Galacs/carte-meteo-lora-2/README.md

# Carte meteo lora 2

## Pin definitions

```c
#define LORA_RST_PIN 24
#define LORA_DIO1_PIN 25
#define LORA_BUSY_PIN 27
#define LORA_DIO3_PIN 26
#define LORA_CS_PIN 3
#define LORA_SCK_PIN 2
#define LORA_MISO_PIN 4
#define LORA_MOSI 5

#define SCL_PIN 6
#define SDA_PIN 7

#define RGB_PIN 23
```
