Galacs/carte-meteo-lora-2/carte-meteo-lora-2.kicad_pcb

## KiCad design carte-meteo-lora-2.kicad_pcb (2026-05-30)

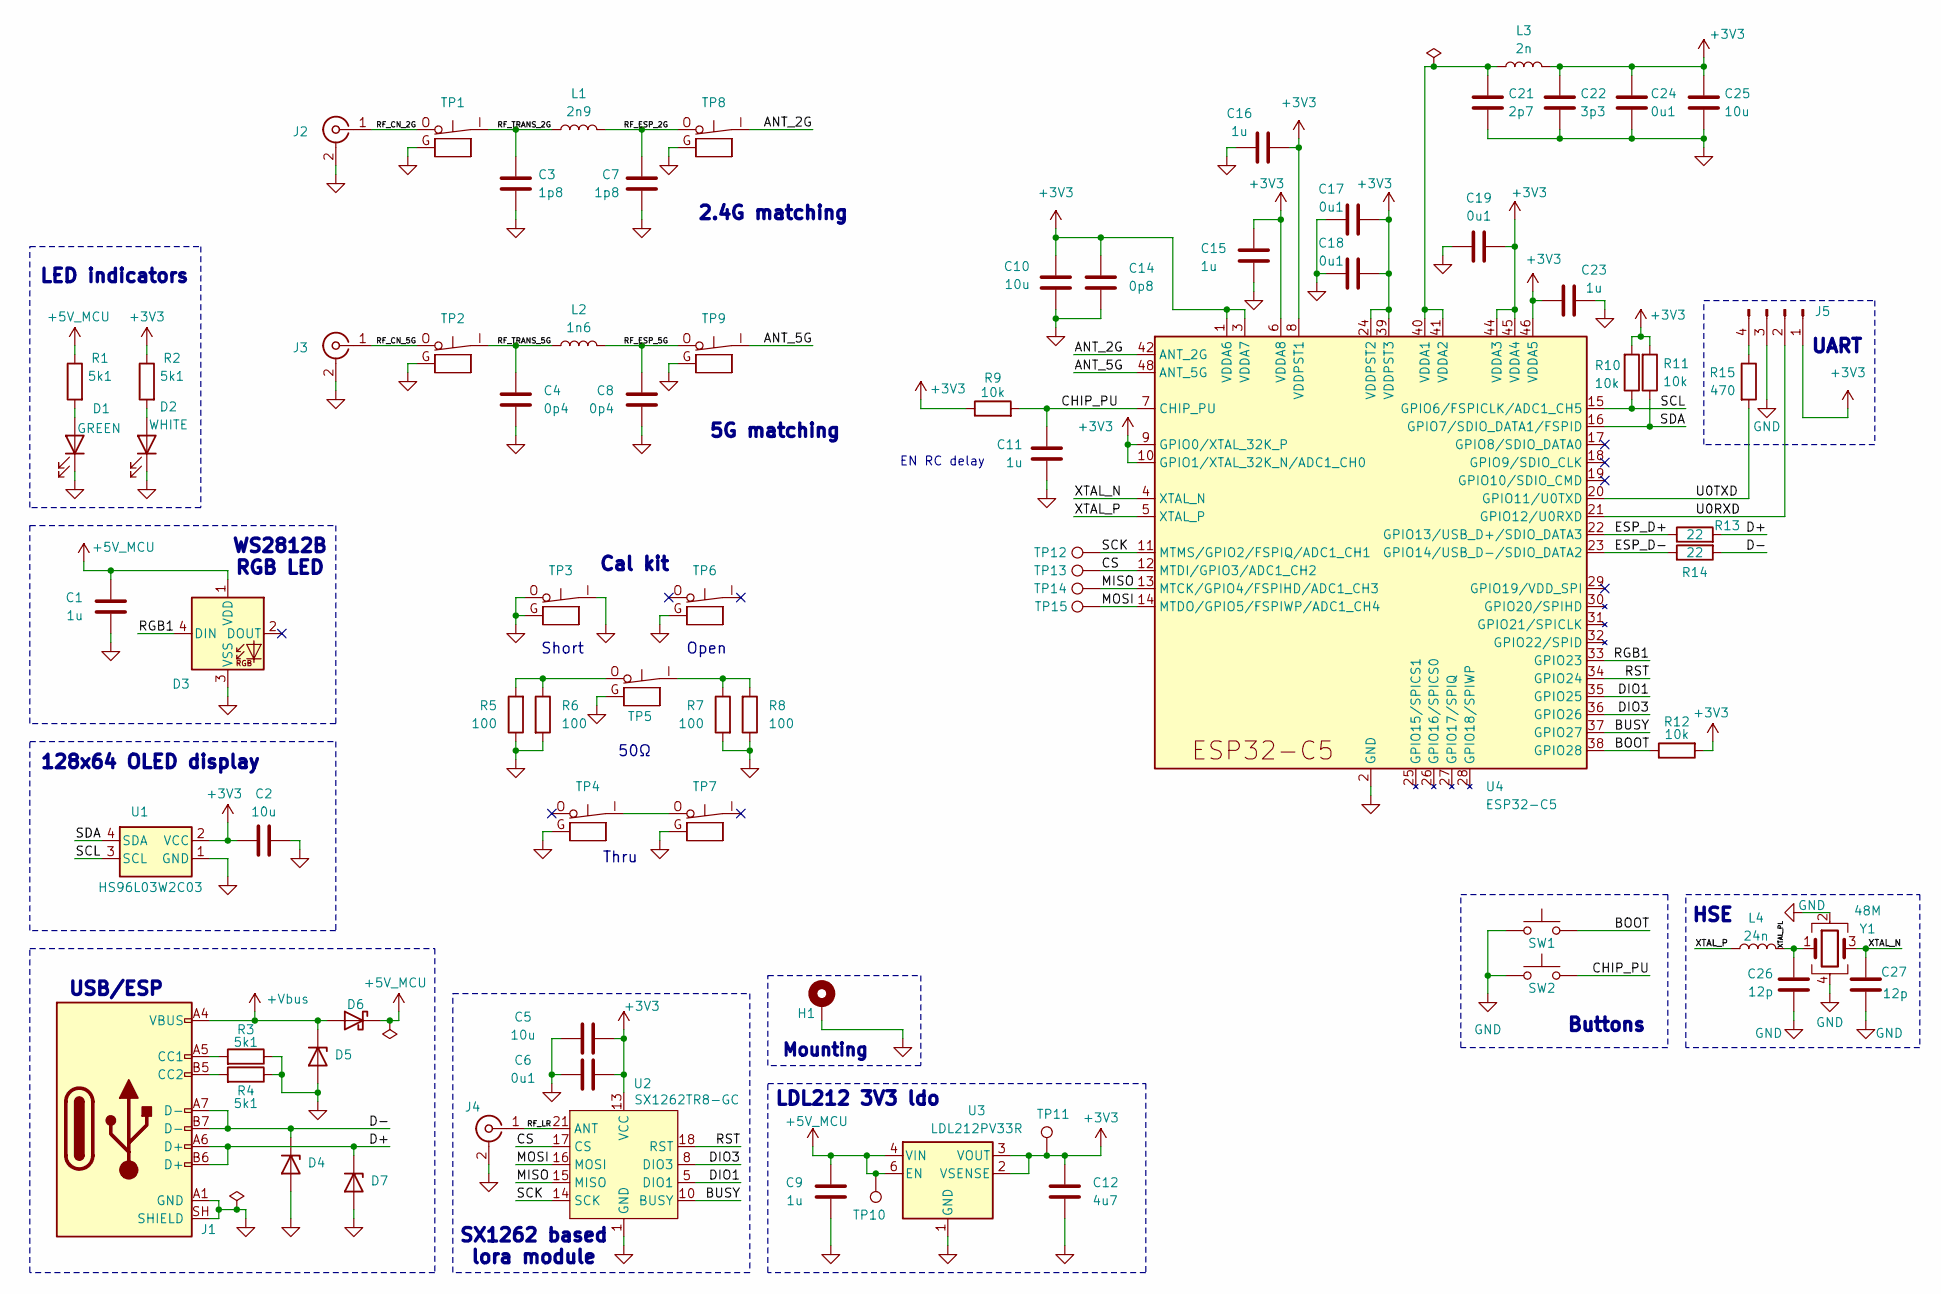
[picture p1: schematic carte-meteo-lora-2.kicad_sch, Carte Meteo Lora 2]

Parts:
C1, C9, C11, C15, C16, C23: 1u; C_0402_1005Metric; Manufacturer Part Number CL05A105KA5NQNC; JLCPCB Part # C52923
C2, C5, C10, C25: 10u; C_0402_1005Metric; Manufacturer Part Number CL05A106MQ5NUNC; JLCPCB Part # C15525
C3, C7: 1p8; C_0402_1005Metric; Manufacturer Part Number GJM1555C1H1R8WB01D; JLCPCB Part # C76903
C4, C8: 0p4; C_0402_1005Metric; Manufacturer Part Number GJM1555C1HR40BB01D; JLCPCB Part # C76910
C6, C17, C18, C19, C24: 0u1; C_0402_1005Metric; Manufacturer Part Number CL05B104KB54PNC; JLCPCB Part # C307331
C12: 4u7; C_0402_1005Metric; Manufacturer Part Number CL05A475MP5NRNC; JLCPCB Part # C23733
C14: 0p8; C_0402_1005Metric; Manufacturer Part Number CC0402BRNPO9BNR80; JLCPCB Part # C327032
C21: 2p7; C_0402_1005Metric; Manufacturer Part Number 0402CG2R7C500NT; JLCPCB Part # C1561
C22: 3p3; C_0402_1005Metric; Manufacturer Part Number 0402CG3R3C500NT; JLCPCB Part # C1565
C26, C27: 12p; C_0402_1005Metric; Manufacturer Part Number 0402CG120J500NT; JLCPCB Part # C1547
D1: GREEN; LED_0805_2012Metric; Manufacturer Part Number KT-0805G; JLCPCB Part # C2297
D2: WHITE; LED_0603_1608Metric; Manufacturer Part Number KT-0603W; JLCPCB Part # C2290
D3: WS2812B; LED_WS2812B_PLCC4_5.0x5.0mm_P3.2mm; Manufacturer Part Number WS2812B-V5/W; JLCPCB Part # C2874885
D4, D5, D7: H5VU10U; Diode_DFN1006; Manufacturer Part Number H5VU10U; JLCPCB Part # C22395519
D6: D_Schottky; D_SMA; Manufacturer Part Number SS54; JLCPCB Part # C22452
H1: MountingHole_Pad; MountingHole_2.2mm_M2_Pad_Via
J1: USB_C_Receptacle_USB2.0_14P; USB_C_Receptacle_HRO_TYPE-C-31-M-12; Manufacturer Part Number TYPE-C16PIN; JLCPCB Part # C393939
J2, J3, J4: Conn_Coaxial; SMA_BAT_Wireless_BWSMA-KWE-Z001; Manufacturer Part Number BWSMA-KWE-Z001; JLCPCB Part # C496551
J5: Conn_01x04_Pin; PinHeader_1x04_P2.54mm_Vertical
L1: 2n9; L_0402_1005Metric; Manufacturer Part Number MWI0402UC2N9JST-HF; JLCPCB Part # C48946217
L2: 1n6; L_0402_1005Metric; Manufacturer Part Number LQG15HS1N6S02D; JLCPCB Part # C162539
L3: 2n; L_0402_1005Metric; Manufacturer Part Number LQG15HS2N0S02D; JLCPCB Part # C18216
L4: 24n; L_0402_1005Metric; Manufacturer Part Number LQW15AN24NG00D; JLCPCB Part # C167472
R1, R2, R3, R4: 5k1; R_0402_1005Metric; Manufacturer Part Number 0402WGF5101TCE; JLCPCB Part # C25905
R5, R6, R7, R8: 100; R_0402_1005Metric; Manufacturer Part Number 0402WGF1000TCE; JLCPCB Part # C25076
R9, R10, R11, R12: 10k; R_0402_1005Metric; Manufacturer Part Number 0402WGF1002TCE; JLCPCB Part # C25744
R13, R14: 22; R_0402_1005Metric; Manufacturer Part Number 0402WGF220JTCE; JLCPCB Part # C25092
R15: 470; R_0402_1005Metric; Manufacturer Part Number 0402WGF4700TCE; JLCPCB Part # C25117
SW1, SW2: SW_Push; SW_SPST_TS-1088-xR020; Manufacturer Part Number TS-1088-AR02016; JLCPCB Part # C720477
TP1, TP2, TP3, TP4, TP5, TP6, TP7, TP8, TP9: RF_switch_connector; Murata_MM8930-2620; Manufacturer Part Number MM8930-2620RJ4; JLCPCB Part # C6227587
TP10, TP11: TestPoint; TestPoint_Pad_D2.0mm
TP12, TP13, TP14, TP15: TestPoint; TestPoint_Pad_D1.0mm
U1: HS96L03W2C03; Manufacturer Part Number HS96L03W2C03; JLCPCB Part # C5248080
U2: SX1262TR8-GC; Silicontra_SX1262ZTR8; Manufacturer Part Number SX1262TR8-GC; JLCPCB Part # C42381682
U3: LDL212PV33R; DFN-6-1EP_2x2mm_P0.5mm_ST; Manufacturer Part Number LDL212PV33R; JLCPCB Part # C2969892
U4: ESP32-C5; QFN-48-1EP_6x6mm_P0.4mm_EP4.6x4.6mm; Manufacturer Part Number ESP32-C5HF4
Y1: 48M; Crystal_SMD_2016-4Pin_2.0x1.6mm; Manufacturer Part Number R940000096; JLCPCB Part # C7206306

Connections:
+3V3: C2.2, C5.1, C6.2, C10.1, C12.1, C14.1, C15.2, C16.2, C17.2, C18.2, C19.1, C22.1, C23.1, C24.1, C25.1, J5.1, L3.2, R2.1, R9.1, R10.2, R11.2, R12.2, TP11.1 (1_1), U1.2 (VCC), U2.13 (VCC), U3.2 (VSENSE), U3.3 (VOUT), U4.1 (VDDA6), U4.3 (VDDA7), U4.6 (VDDA8), U4.8 (VDDPST1), U4.9 (GPIO0/XTAL_32K_P), U4.10 (GPIO1/XTAL_32K_N/ADC1_CH0), U4.24 (VDDPST2), U4.39 (VDDPST3), U4.44 (VDDA3), U4.45 (VDDA4), U4.46 (VDDA5)
+5V_MCU: C1.1, C9.1, D3.1 (VDD), D6.1 (K), R1.1, TP10.1 (1_1), U3.4 (VIN), U3.6 (EN)
+Vbus: D5.1 (K), D6.2 (A), J1.A4 (VBUS), J1.A9 (VBUS), J1.B4 (VBUS), J1.B9 (VBUS)
/ANT_2G: TP8.I, U4.42 (ANT_2G)
/ANT_5G: TP9.I, U4.48 (ANT_5G)
/BOOT: R12.1, SW1.2, U4.38 (GPIO28)
/BUSY: U2.10 (BUSY), U4.37 (GPIO27)
/CHIP_PU: C11.1, R9.2, SW2.2, U4.7 (CHIP_PU)
/CS: TP13.1 (1_1), U2.17 (CS), U4.12 (MTDI/GPIO3/ADC1_CH2)
/D+: D7.1 (K), J1.A6 (D+), J1.B6 (D+), R13.2
/D-: D4.1 (K), J1.A7 (D-), J1.B7 (D-), R14.2
/DIO1: U2.5 (DIO1), U4.35 (GPIO25)
/DIO3: U2.8 (DIO3), U4.36 (GPIO26)
/ESP_D+: R13.1, U4.22 (GPIO13/USB_D+/SDIO_DATA3)
/ESP_D-: R14.1, U4.23 (GPIO14/USB_D-/SDIO_DATA2)
/MISO: TP14.1 (1_1), U2.15 (MISO), U4.13 (MTCK/GPIO4/FSPIHD/ADC1_CH3)
/MOSI: TP15.1 (1_1), U2.16 (MOSI), U4.14 (MTDO/GPIO5/FSPIWP/ADC1_CH4)
/RF_CN_2G: J2.1 (In), TP1.O
/RF_CN_5G: J3.1 (In), TP2.O
/RF_ESP_2G: C7.1, L1.1, TP8.O
/RF_ESP_5G: C8.2, L2.1, TP9.O
/RF_LR: J4.1 (In), U2.21 (ANT)
/RF_TRANS_2G: C3.1, L1.2, TP1.I
/RF_TRANS_5G: C4.2, L2.2, TP2.I
/RGB1: D3.4 (DIN), U4.33 (GPIO23)
/RST: U2.18 (RST), U4.34 (GPIO24)
/SCK: TP12.1 (1_1), U2.14 (SCK), U4.11 (MTMS/GPIO2/FSPIQ/ADC1_CH1)
/SCL: R10.1, U1.3 (SCL), U4.15 (GPIO6/FSPICLK/ADC1_CH5)
/SDA: R11.1, U1.4 (SDA), U4.16 (GPIO7/SDIO_DATA1/FSPID)
/U0RXD: J5.2, U4.21 (GPIO12/U0RXD)
/U0TXD: R15.2, U4.20 (GPIO11/U0TXD)
/XTAL_N: C27.1, U4.4 (XTAL_N), Y1.3
/XTAL_P: L4.1, U4.5 (XTAL_P)
/XTAL_PL: C26.2, L4.2, Y1.1
GND: C1.2, C2.1, C3.2, C4.1, C5.2, C6.1, C7.2, C8.1, C9.2, C10.2, C11.2, C12.2, C14.2, C15.1, C16.1, C17.1, C18.1, C19.2, C21.2, C22.2, C23.2, C24.2, C25.2, C26.1, C27.2, D1.1 (K), D2.1 (K), D3.3 (VSS), D4.2 (A), D5.2 (A), D7.2 (A), H1.1 (1_1), J1.A1 (GND), J1.A12 (GND), J1.B1 (GND), J1.B12 (GND), J1.SH (SHIELD), J2.2 (Ext), J3.2 (Ext), J4.2 (Ext), J5.3, R3.1, R4.1, R5.1, R6.2, R7.2, R8.1, SW1.1, SW2.1, TP1.G, TP2.G, TP3.G, TP3.I, TP3.O, TP4.G, TP5.G, TP6.G (G_G), TP7.G, TP8.G, TP9.G, U1.1 (GND), U2.1 (GND), U2.2 (GND), U2.3 (GND), U2.4 (GND), U2.11 (GND), U2.12 (GND), U2.19 (GND), U2.20 (GND), U2.22 (GND), U3.1 (GND), U4.2 (GND), U4.43 (GND), U4.47 (GND), U4.49 (GND), Y1.2, Y1.4
unnamed: D1.2 (A), R1.2
unnamed: D2.2 (A), R2.2
unnamed: J1.A5 (CC1), R3.2
unnamed: J1.B5 (CC2), R4.2
unnamed: J5.4, R15.1
unnamed: R5.2, R6.1, TP5.O
unnamed: R7.1, R8.2, TP5.I
unnamed: TP4.I, TP7.O
unnamed: C21.1, L3.1, U4.40 (VDDA1), U4.41 (VDDA2)

Notes on the sheet:
2.4G matching
EN RC delay
Thru
Cal kit
LED indicators
WS2812B RGB LED
HSE
SX1262 based lora module
Short
50Ω
USB/ESP
5G matching
LDL212 3V3 ldo
Buttons
UART
Mounting
128x64 OLED display
Open

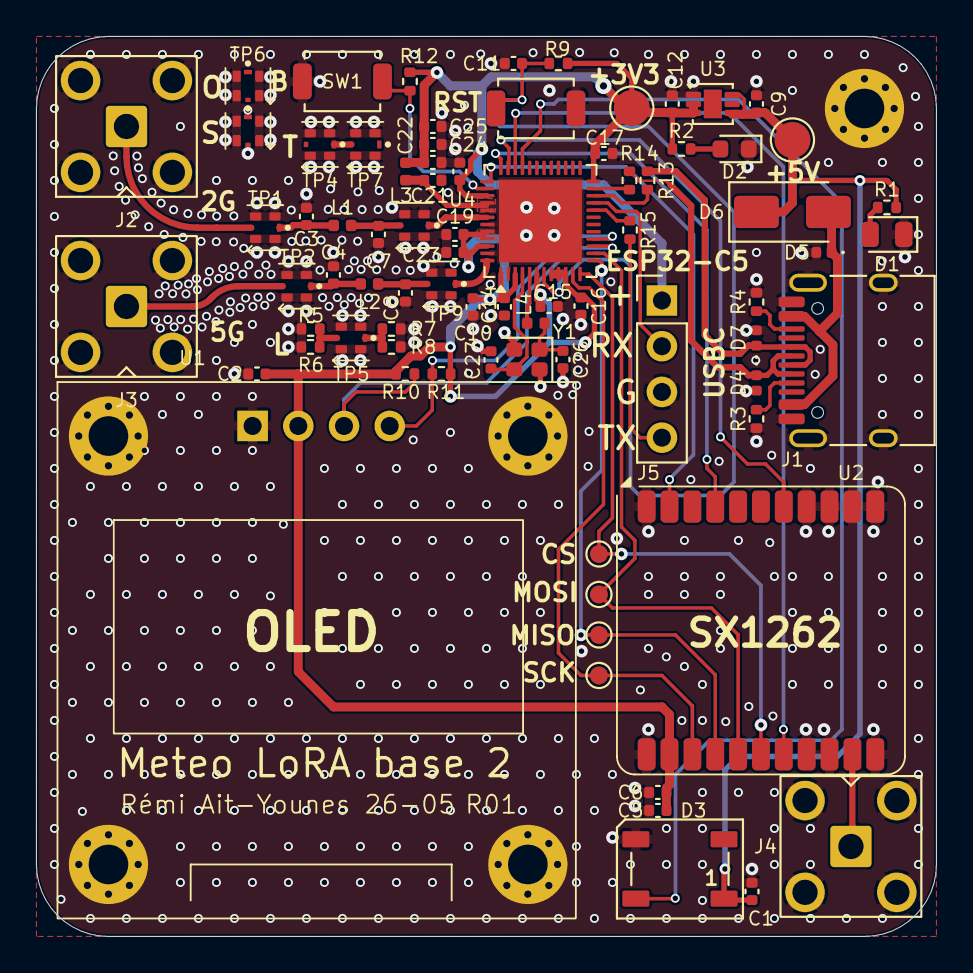
[picture p2: board carte-meteo-lora-2.kicad_pcb from above]

Board: 4 copper layers, 50.0 x 50.0 mm, 79 parts (0 on the bottom side), 44 nets.
