Galacs/carte-meteo-lora-2/(commit log)

2026-05-25 schem: add boot/rst buttons
    [carte-meteo-lora-2.kicad_sch]
2026-05-25 schem: add LDL212 3V3 ldo
    [carte-meteo-lora-2.kicad_sch]
2026-05-25 schem: connect gpios to mcu
    [carte-meteo-lora-2.kicad_sch]
2026-05-26 schem: add cal kit
    [carte-meteo-lora-2.kicad_sch]
2026-05-26 schem: add no connects
    [carte-meteo-lora-2.kicad_sch]
2026-05-26 schem: add led pwr indicators
    [carte-meteo-lora-2.kicad_sch]
2026-05-26 schem: add test points
    [carte-meteo-lora-2.kicad_sch]
2026-05-26 schem: add net classes
    [carte-meteo-lora-2.kicad_sch]
2026-05-26 schem: assign footprints
    [carte-meteo-lora-2.kicad_sch]
2026-05-26 schem: add title
    [carte-meteo-lora-2.kicad_sch]
2026-05-26 schem: add ordering info to BOM
    [carte-meteo-lora-2.kicad_sch]
2026-05-26 schem: renumber
    [carte-meteo-lora-2.kicad_sch]
2026-05-26 pcb: import 4 layer jlc stackup
    [carte-meteo-lora-2.kicad_pcb]
2026-05-26 pcb: import footprints from schem
    [carte-meteo-lora-2.kicad_pcb, carte-meteo-lora-2.kicad_sch]
2026-05-26 pcb: add missing 3d models
    [carte-meteo-lora-2.kicad_pcb]
2026-05-27 pcb: initial sectioning
    [carte-meteo-lora-2.kicad_pcb]
2026-05-27 pcb: add usb inital layout
    [carte-meteo-lora-2.kicad_pcb]
2026-05-27 pcb: add initial rf layout
    [carte-meteo-lora-2.kicad_pcb]
2026-05-27 pcb: add initial crystal layout
    [carte-meteo-lora-2.kicad_pcb]
2026-05-27 pcb: initial section
    [carte-meteo-lora-2.kicad_pcb, carte-meteo-lora-2.kicad_sch]
2026-05-27 pcb: add edge cut
    [carte-meteo-lora-2.kicad_pcb, carte-meteo-lora-2.kicad_sch]
2026-05-27 pcb: add m2 mouting holes
    [carte-meteo-lora-2.kicad_pcb, carte-meteo-lora-2.kicad_sch]
2026-05-27 pcb: add inital layout
    [carte-meteo-lora-2.kicad_pcb, carte-meteo-lora-2.kicad_sch]
2026-05-27 pcb: add gnd vias
    [carte-meteo-lora-2.kicad_pcb]
2026-05-27 pcb: add grid/place origin
    [carte-meteo-lora-2.kicad_pcb]
2026-05-27 pcb: reorganize programmable gpios
    [carte-meteo-lora-2.kicad_pcb, carte-meteo-lora-2.kicad_sch]
2026-05-27 pcb: add rf routing
    [carte-meteo-lora-2.kicad_pcb]
2026-05-27 pcb: add crystal routing
    [carte-meteo-lora-2.kicad_pcb]
2026-05-27 pcb: add usb routing
    [carte-meteo-lora-2.kicad_pcb]
2026-05-27 pcb: add uart routing
    [carte-meteo-lora-2.kicad_pcb]
2026-05-27 pcb: add i2c routing
    [carte-meteo-lora-2.kicad_pcb]
2026-05-27 pcb: add lora module routing
    [carte-meteo-lora-2.kicad_pcb, carte-meteo-lora-2.kicad_sch]
2026-05-27 pcb: add +3v3 pwr routing
    [carte-meteo-lora-2.kicad_pcb, carte-meteo-lora-2.kicad_sch]
2026-05-29 pcb: finish routing 3v3
    [carte-meteo-lora-2.kicad_pcb]
2026-05-29 pcb: add +5v pwr routing
    [carte-meteo-lora-2.kicad_pcb]
2026-05-29 pcb: route boot and rst
    [carte-meteo-lora-2.kicad_pcb, carte-meteo-lora-2.kicad_sch]
2026-05-29 pcb: clean up traces
    [carte-meteo-lora-2.kicad_pcb]
2026-05-29 pcb: add stitching vias
    [carte-meteo-lora-2.kicad_pcb]
2026-05-29 pcb: run and fix DRC
    [carte-meteo-lora-2.kicad_pcb]
2026-05-29 pcb: remove unused internal pads
    [carte-meteo-lora-2.kicad_pcb]
2026-05-29 pcb(silk): clean up reference designators
    [carte-meteo-lora-2.kicad_pcb]
2026-05-29 pcb(silk): add user txt
    [carte-meteo-lora-2.kicad_pcb]
2026-05-29 pcb: add title
    [carte-meteo-lora-2.kicad_pcb]
2026-05-29 pcb: add lora missing 3d model
    [carte-meteo-lora-2.kicad_pcb]
2026-05-29 generate production files
    [bom.csv, designators.csv, positions.csv]
2026-05-30 pcb: add base station graphic
    [carte-meteo-lora-2.kicad_pcb]
2026-05-30 pcb(silk): add indications
    [carte-meteo-lora-2.kicad_pcb]
2026-05-30 regenerate production files
    [carte-meteo-lora-2.kicad_pcb, designators.csv]
2026-06-08 docs: add pin definitions
